XLNC-APEX/WRO_FE_2026_NATIONAL/README.md

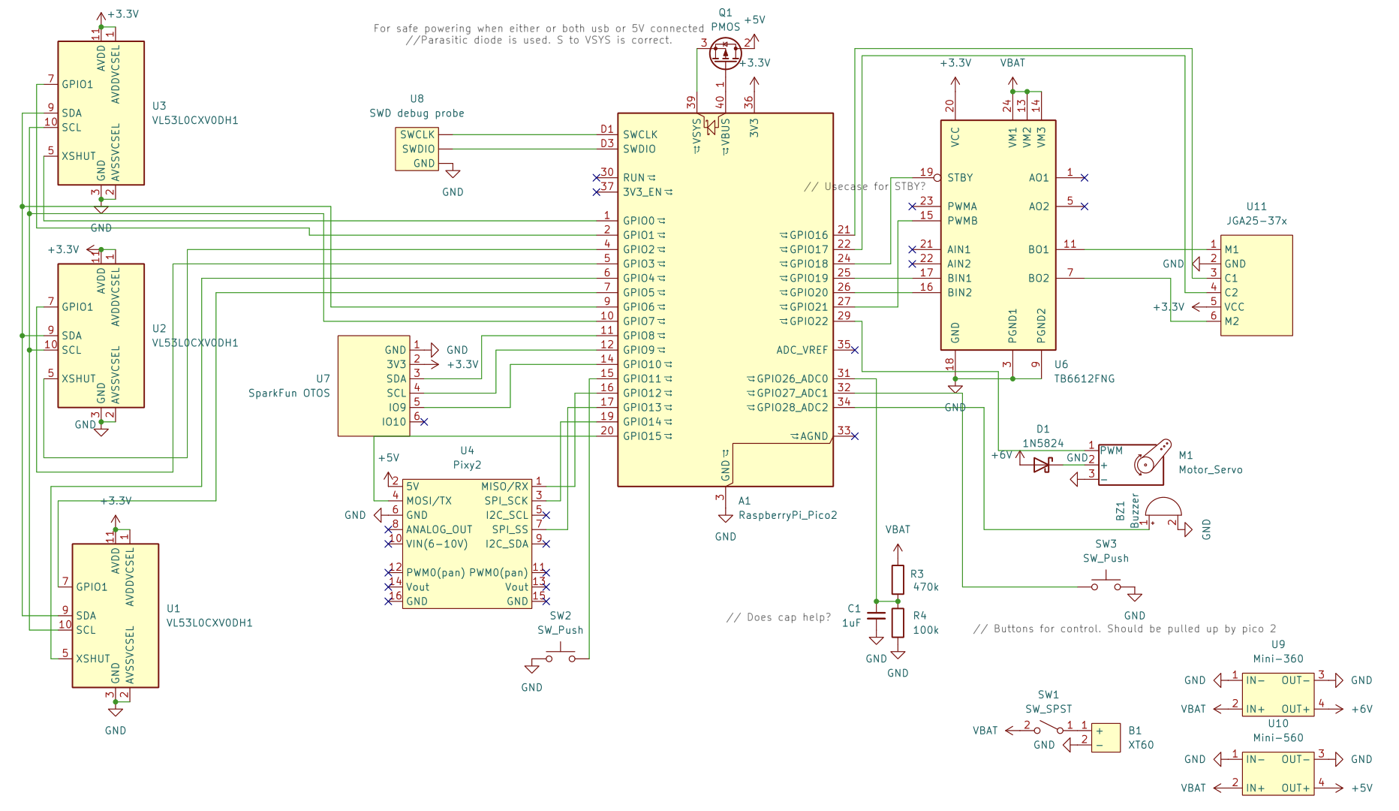
[picture p1: docs/images/schematic.png]
Screenshot of the electronic schematic made in KiCad
