XLNC-APEX/WRO_FE_2026_NATIONAL/hardware/cad/car.png

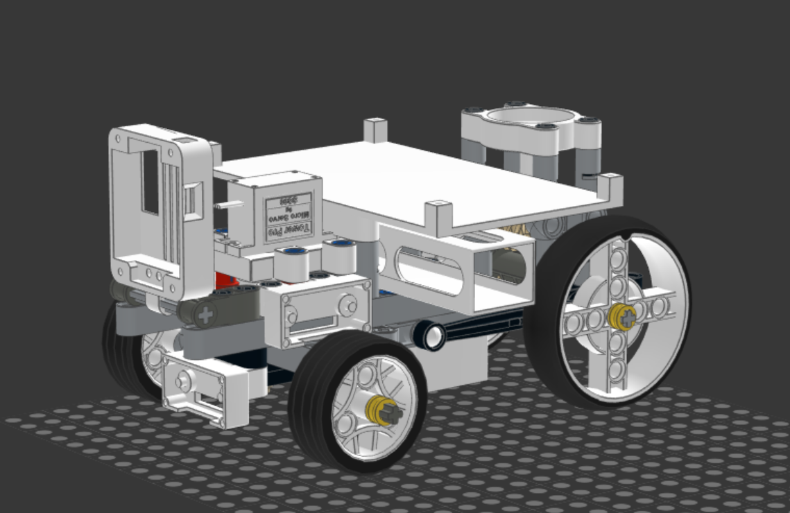
hardware/cad/car.png
