XLNC-APEX/WRO_FE_2026_NATIONAL/hardware/cad/motor.FCStd

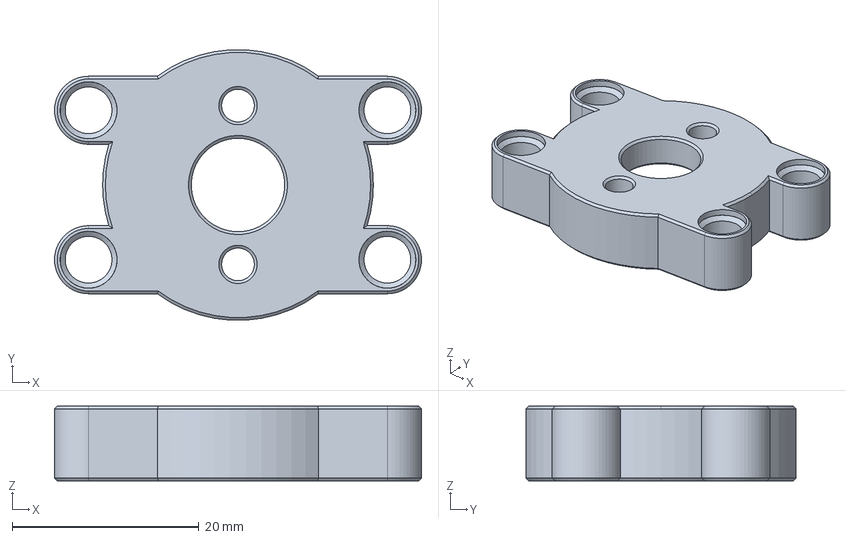
[picture p3: CAD file, 2026-07-25]
hardware/cad/motor.FCStd
39.3 x 29.0 x 8.00 mm
