XLNC-APEX/WRO_FE_2026_NATIONAL/hardware/cad/motor-adapter.FCStd

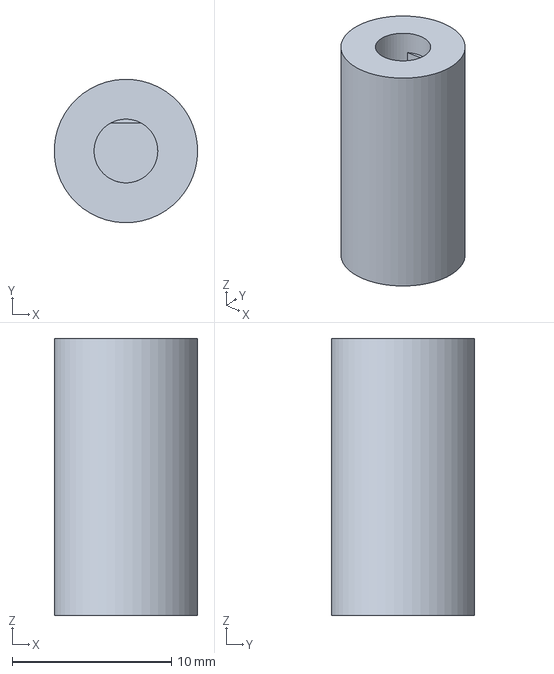
[picture p4: CAD file, 2026-07-25]
hardware/cad/motor-adapter.FCStd
8.99 x 9.00 x 17.4 mm
