XLNC-APEX/WRO_FE_2026_NATIONAL/hardware/cad/perfboard-holder.3mf

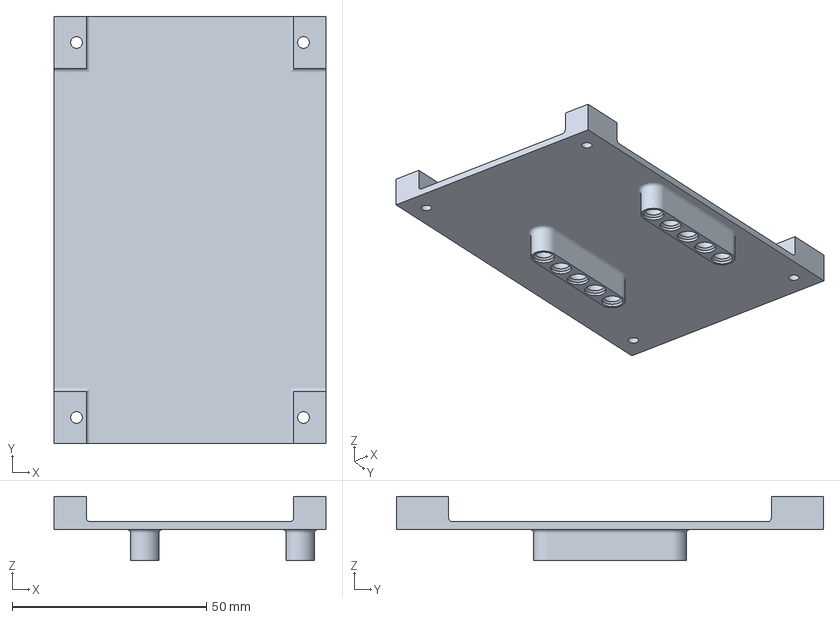
[picture p5: CAD file, 2026-06-13]
hardware/cad/perfboard-holder.3mf
70.0 x 110.0 x 16.5 mm
