XLNC-APEX/WRO_FE_2026_NATIONAL/hardware/cad/tof.FCStd

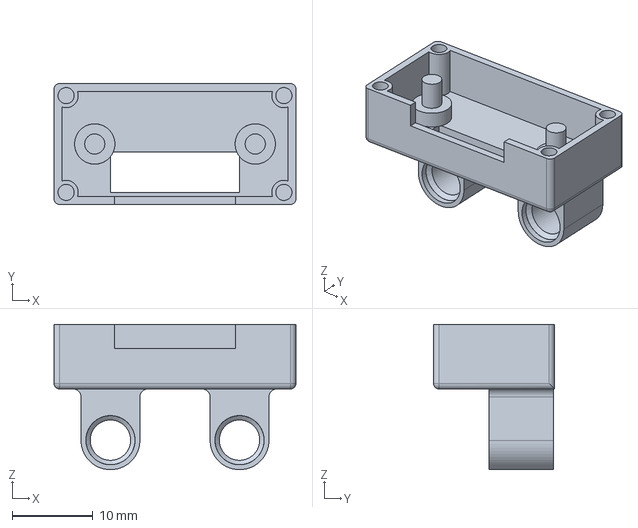
[picture p6: CAD file, 2026-06-13]
hardware/cad/tof.FCStd
30.0 x 15.0 x 18.0 mm
