XLNC-APEX/WRO_FE_2026_NATIONAL/hardware/cad/otos-adapter.3mf

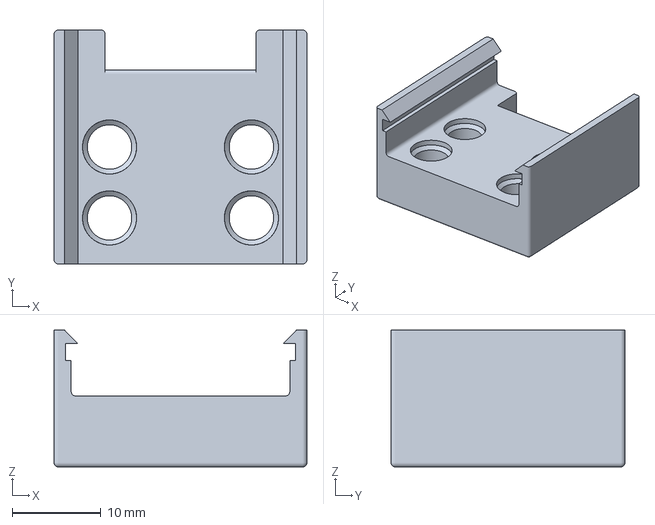
[picture p7: CAD file, 2026-06-13]
hardware/cad/otos-adapter.3mf
28.5 x 26.4 x 15.4 mm
