XLNC-APEX/WRO_FE_2026_NATIONAL/hardware/cad/servo-holder-holder.3mf

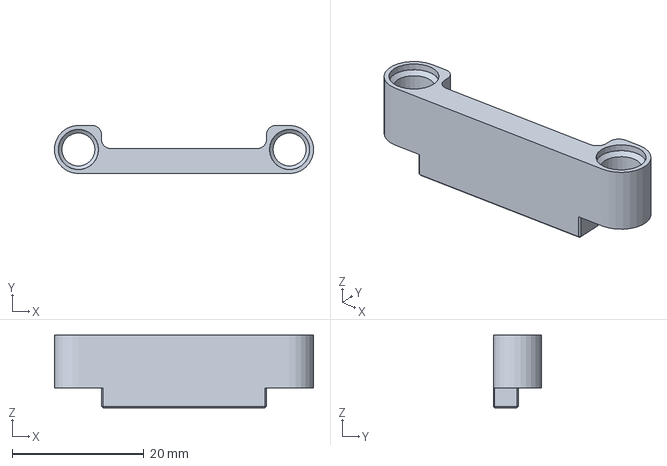
[picture p8: CAD file, 2026-06-13]
hardware/cad/servo-holder-holder.3mf
39.2 x 7.30 x 11.0 mm
