XLNC-APEX/WRO_FE_2026_NATIONAL/hardware/cad/servo-holder.FCStd

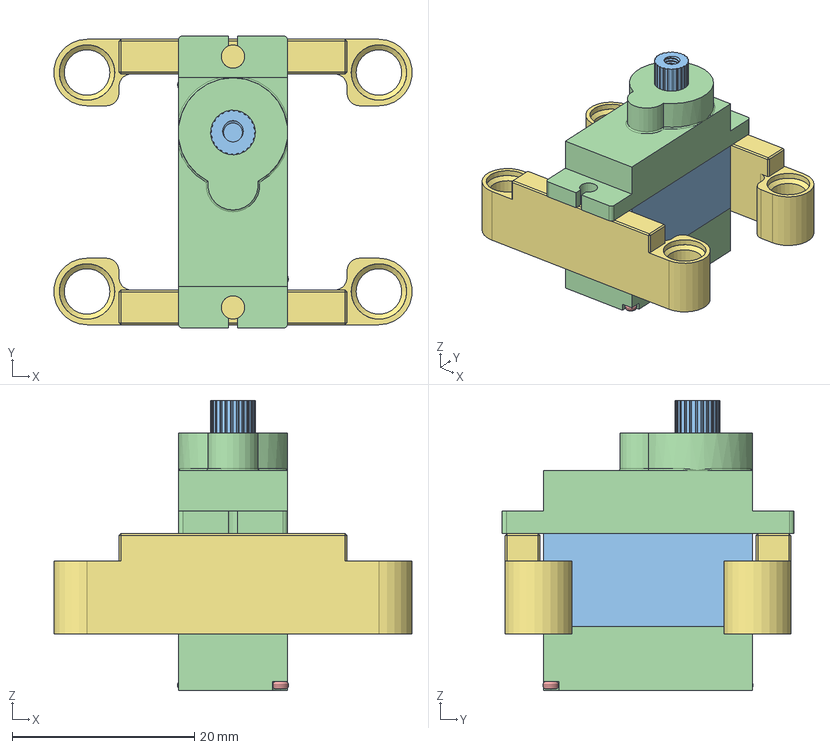
[picture p9: CAD file, 2026-06-13]
hardware/cad/servo-holder.FCStd
39.2 x 32.1 x 31.8 mm
Micro Motor v4
Micro Motor v001
Middel Part v7
Buttom Part v4
Shaft B v4
Gear C v3
Gear C v001
Gear B v1
Gear B v001
Gear A v3
Main Shaft with Gear v3
Upper Part v3
Main Screw v3
Main Screw v001
holder x 2
