XLNC-APEX/WRO_FE_2026_NATIONAL/hardware/cad/servo_adapter.FCStd

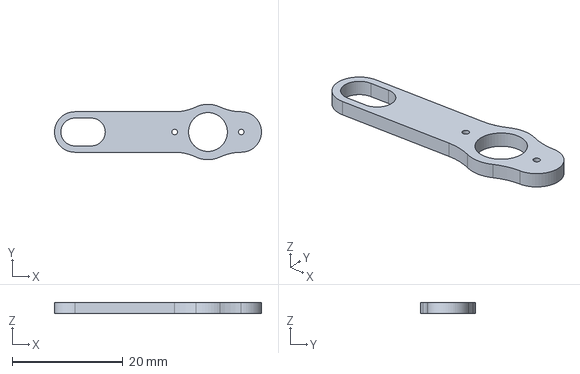
[picture p10: CAD file, 2026-06-13]
hardware/cad/servo_adapter.FCStd
37.3 x 10.00 x 2.05 mm
