XLNC-APEX/WRO_FE_2026_NATIONAL/hardware/cad/battery.FCStd

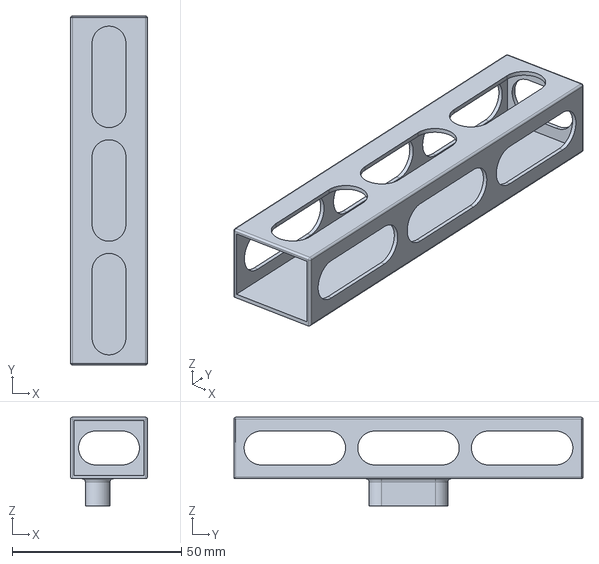
[picture p11: CAD file, 2026-06-08]
hardware/cad/battery.FCStd
22.7 x 103.2 x 26.2 mm
