XLNC-APEX/WRO_FE_2026_NATIONAL/hardware/cad/tof-cover.3mf

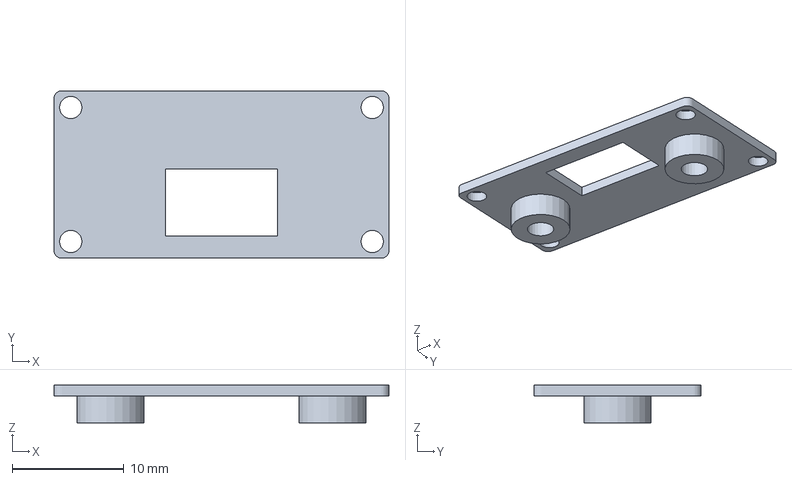
[picture p12: CAD file, 2026-06-06]
hardware/cad/tof-cover.3mf
30.0 x 15.0 x 3.40 mm
