XLNC-APEX/WRO_FE_2026_NATIONAL/hardware/cad/pixy_2_case.3mf

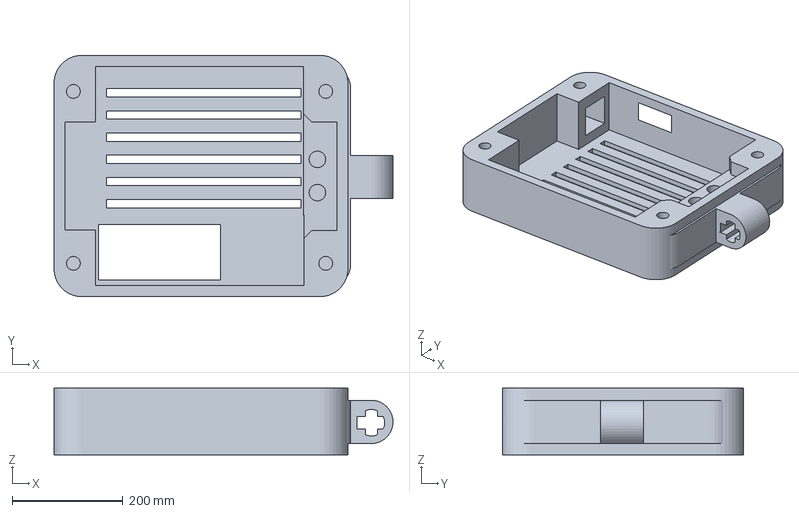
[picture p13: CAD file, 2026-06-06]
hardware/cad/pixy_2_case.3mf
611.2 x 435.0 x 120.0 mm
