XLNC-APEX/WRO_FE_2026_NATIONAL/hardware/cad/servo.FCStd

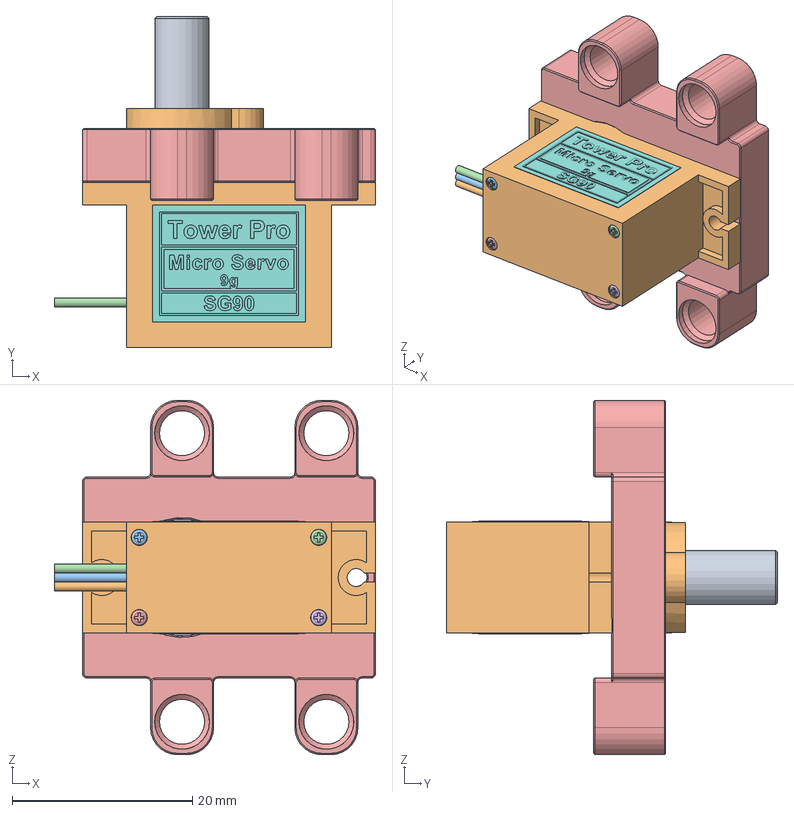
[picture p14: CAD file, 2026-06-03]
hardware/cad/servo.FCStd
35.6 x 36.7 x 39.3 mm
adapter
SG90 v1
SG90 v001
SG90 v002
SG90 v003
SG90 v004
SG90 v005
SG90 v006
SG90 v007
SG90 v008
SG90 v009
SG90 v010
holder
