XLNC-APEX/WRO_FE_2026_NATIONAL/(list of files, cad)

Other CAD files:
hardware/cad/perfboard.FCStd
hardware/cad/tof-case.3mf
hardware/cad/otos.FCStd
hardware/cad/battery-holder.3mf
hardware/cad/motor-holder.3mf
hardware/cad/motor-adapter.3mf
hardware/cad/servo-adapter.3mf
hardware/cad/servo-holder.3mf
