XLNC-APEX/WRO_FE_2026_NATIONAL/hardware/schematics/car/car.kicad_pcb

## KiCad design hardware/schematics/car/car.kicad_pcb (2026-06-13)

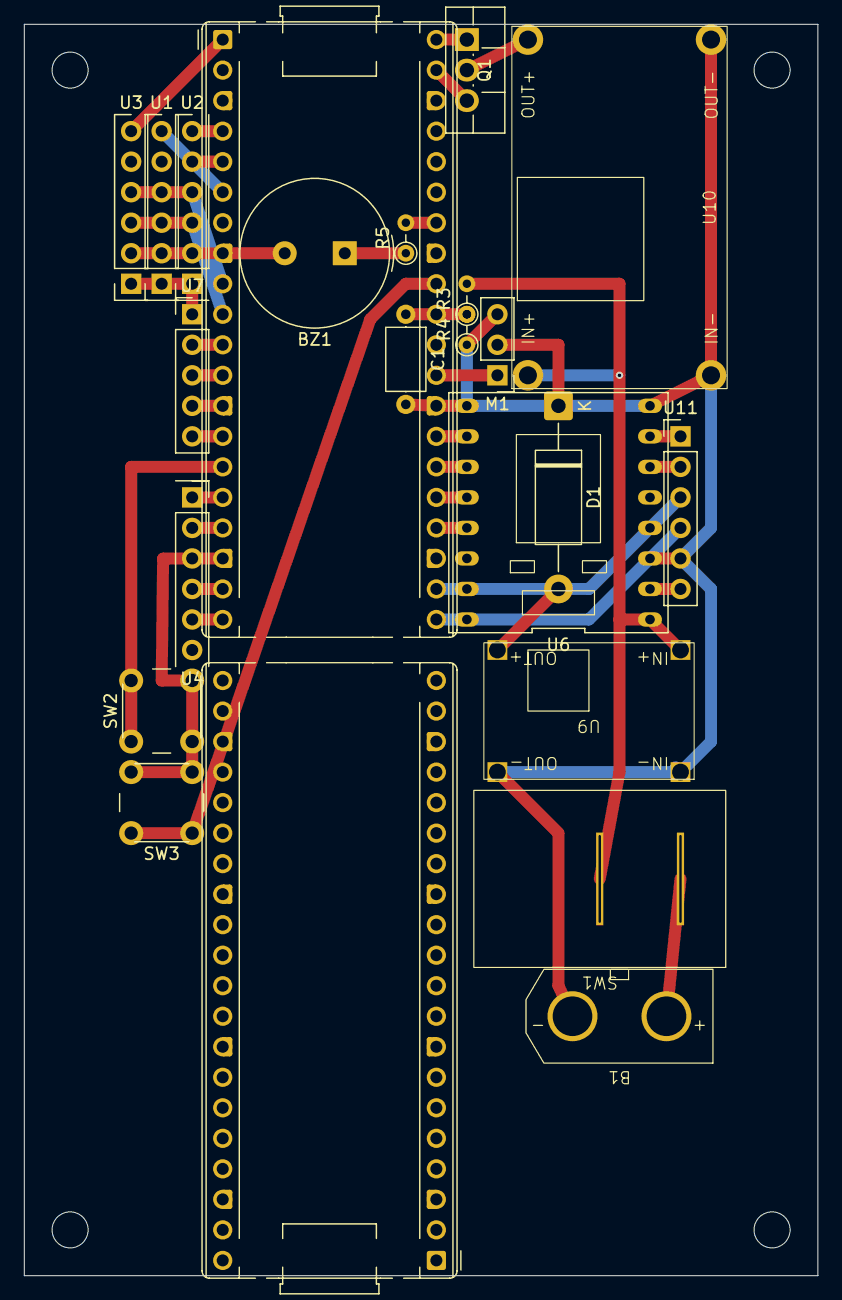
[picture p15: board car.kicad_pcb from above]

Board: 12 copper layers, 66.0 x 104.1 mm, 23 parts (0 on the bottom side), 38 nets.

Parts:
A1, A1#2: RaspberryPi_Pico2; RaspberryPi_Pico_Common_THT
B1: XT60
BZ1: Buzzer; Buzzer_TDK_PS1240P02BT_D12.2mm_H6.5mm
C1: 1uF; C_Axial_L5.1mm_D3.1mm_P7.50mm_Horizontal
D1: 1N5824; D_DO-15_P15.24mm_Horizontal
M1: Motor_Servo; PinHeader_1x03_P2.54mm_Vertical
Q1: PMOS; TO-220F-3_Vertical
R3: 470k; R_Axial_DIN0204_L3.6mm_D1.6mm_P2.54mm_Vertical
R4: 100k; R_Axial_DIN0204_L3.6mm_D1.6mm_P2.54mm_Vertical
R5: 200; R_Axial_DIN0204_L3.6mm_D1.6mm_P2.54mm_Vertical
SW1: SW_SPST; SW_SPST_20.96mmx14.74mm
SW2, SW3: SW_Push; SW_PUSH_6mm_5.08mm
U1, U2, U3: VL53L0CXV0DH1; VL53L0_1XV2_PinHeader_1x06_P2.54mm_Vertical
U4: Pixy2; Pixy2_PinHeader_1x06_P2.54mm_Vertical
U6: TB6612FNG; TB6612FNG_Breakout_Sparkfun
U7: SparkFun OTOS; Sparkfun_OTOS_PinHeader_1x05_P2.54mm_Vertical
U9: Mini-360; Buck_Mini-360_2.54mm
U10: Mini-560; Buck_Mini-560_2.54mm
U11: JGA25-37x; JGA25-37x_PinHeader_1x06_P2.54mm_Vertical

Connections:
+3.3V: A1.36 (3V3), A1#2.36 (3V3), U1.11 (AVDD), U2.11 (AVDD), U3.11 (AVDD), U6.20 (VCC), U7.2 (3V3), U11.5 (VCC)
+5V: Q1.2 (D), U4.2 (5V), U10.4 (OUT+)
+6V: D1.2 (A), U9.4 (OUT+)
GND: A1.3 (GND), A1.8 (GND), A1.13 (GND), A1.18 (GND), A1.23 (GND), A1.28 (GND), A1.38 (GND), A1#2.3 (GND), A1#2.8 (GND), A1#2.13 (GND), A1#2.18 (GND), A1#2.23 (GND), A1#2.28 (GND), A1#2.38 (GND), B1.2 (-), BZ1.2 (-), C1.2, M1.3 (-), R4.1, SW2.2, SW3.2, U1.3 (GND), U2.3 (GND), U3.3 (GND), U4.6 (GND), U6.18 (GND), U7.1 (GND), U9.1 (IN-), U9.3 (OUT-), U10.1 (IN-), U10.3 (OUT-), U11.2 (GND)
unnamed: A1.1 (GPIO0), A1#2.1 (GPIO0), U3.5 (XSHUT)
unnamed: A1.2 (GPIO1), A1#2.2 (GPIO1), U3.7 (GPIO1)
unnamed: A1.4 (GPIO2), A1#2.4 (GPIO2), U2.5 (XSHUT)
unnamed: A1.5 (GPIO3), A1#2.5 (GPIO3), U2.7 (GPIO1)
unnamed: A1.6 (GPIO4), A1#2.6 (GPIO4), U1.5 (XSHUT)
unnamed: A1.7 (GPIO5), A1#2.7 (GPIO5), U1.7 (GPIO1)
unnamed: A1.9 (GPIO6), A1#2.9 (GPIO6), U1.9 (SDA), U2.9 (SDA), U3.9 (SDA)
unnamed: A1.10 (GPIO7), A1#2.10 (GPIO7), U1.10 (SCL), U2.10 (SCL), U3.10 (SCL)
unnamed: A1.11 (GPIO8), A1#2.11 (GPIO8), U7.3 (SDA)
unnamed: A1.12 (GPIO9), A1#2.12 (GPIO9), U7.4 (SCL)
unnamed: A1.14 (GPIO10), A1#2.14 (GPIO10), U7.5 (IO9)
unnamed: A1.15 (GPIO11), A1#2.15 (GPIO11), SW2.1
unnamed: A1.16 (GPIO12), A1#2.16 (GPIO12), U4.1 (MISO/RX)
unnamed: A1.17 (GPIO13), A1#2.17 (GPIO13), U4.7 (SPI_SS)
unnamed: A1.19 (GPIO14), A1#2.19 (GPIO14), U4.3 (SPI_SCK)
unnamed: A1.20 (GPIO15), A1#2.20 (GPIO15), U4.4 (MOSI/TX)
unnamed: A1.21 (GPIO16), A1#2.21 (GPIO16), U11.3 (C1)
unnamed: A1.22 (GPIO17), A1#2.22 (GPIO17), U11.4 (C2)
unnamed: A1.24 (GPIO18), A1#2.24 (GPIO18), U6.19 (STBY)
unnamed: A1.25 (GPIO19), A1#2.25 (GPIO19), U6.17 (BIN1)
unnamed: A1.26 (GPIO20), A1#2.26 (GPIO20), U6.16 (BIN2)
unnamed: A1.27 (GPIO21), A1#2.27 (GPIO21), U6.15 (PWMB)
unnamed: A1.29 (GPIO22), A1#2.29 (GPIO22), M1.1 (PWM)
unnamed: A1.31 (GPIO26_ADC0), A1#2.31 (GPIO26_ADC0), C1.1, R3.1, R4.2
unnamed: A1.32 (GPIO27_ADC1), A1#2.32 (GPIO27_ADC1), SW3.1
unnamed: A1.34 (GPIO28_ADC2), A1#2.34 (GPIO28_ADC2), R5.2
unnamed: A1.40 (VBUS), A1#2.40 (VBUS), Q1.1 (G)
unnamed: A1.39 (VSYS), A1#2.39 (VSYS), Q1.3 (S)
unnamed: B1.1 (+), SW1.1 (A)
unnamed: BZ1.1 (+), R5.1
unnamed: D1.1 (K), M1.2 (+)
unnamed: U6.11 (BO1), U11.1 (M1)
unnamed: U6.7 (BO2), U11.6 (M2)
VBAT: R3.2, SW1.2 (B), U6.24 (VM1), U9.2 (IN+), U10.2 (IN+)
