XLNC-APEX/WRO_FE_2026_NATIONAL/firmware/xlnc_apex_robot/src/main.rs

#![no_std]
#![no_main]

extern crate embassy_rp as hal;
use core::f32::consts::FRAC_PI_6;

use defmt::info;
use embassy_executor::Spawner;
use embassy_time::Timer;
use hal::block::ImageDef;
use nalgebra::Point2;
use xlnc_apex_robot::{
    path::LinesPath,
    target::{ApexCar, PurePursuit, PurePursuitConfig, beeper_task, btn_reset, init, pure_pursuit},
};

//Panic Handler
use panic_probe as _;
// Defmt Logging
use defmt_rtt as _;

/// Tell the Boot ROM about our application
#[unsafe(link_section = ".start_block")]
#[used]
pub static IMAGE_DEF: ImageDef = hal::block::ImageDef::secure_exe();

#[embassy_executor::main]
async fn main(spawner: Spawner) {
    let p = hal::init(Default::default());
    let mut devices = init(p).await;
    info!("{}", devices.voltage.get().await.unwrap());
    info!("Intialized! Press btn2 to start. Then btn1 to reset.");
    devices.btn2.wait_for_low().await;
    spawner.spawn(beeper_task(devices.buzzer).unwrap()); // beep();
    spawner.spawn(btn_reset(devices.btn1, devices.watchdog).unwrap());

    devices.otos.reset_tracking().await.unwrap();
    devices.otos.calibrate_imu(255).await.unwrap();
    let ppconf = PurePursuitConfig {
        kl: 1.0,
        min_l: 0.1,
        max_l: 0.5,
        l_drv: 0.096,
        max_steer: FRAC_PI_6,
    };
    let car = ApexCar::new(devices.servo, devices.otos);
    let path_points = [
        Point2::new(0.0, 0.0),
        Point2::new(1.5, 0.0),
        Point2::new(1.5, 1.5),
        Point2::new(0.0, 1.5),
        Point2::new(0.0, 0.0),
        Point2::new(1.5, 0.0),
        Point2::new(1.5, 1.5),
        Point2::new(0.0, 1.5),
        Point2::new(0.0, 0.0),
        Point2::new(1.5, 0.0),
        Point2::new(1.5, 1.5),
        Point2::new(0.0, 1.5),
        Point2::new(0.0, 0.0),
        Point2::new(1.5, 0.0),
        Point2::new(1.5, 1.5),
        Point2::new(0.0, 1.5),
        Point2::new(0.0, 0.0),
        Point2::new(1.5, 0.0),
        Point2::new(1.5, 1.5),
        Point2::new(0.0, 1.5),
        Point2::new(0.0, 0.0),
    ];
    let path = LinesPath::new(path_points);
    let pp = PurePursuit::new(car, path, ppconf);
    spawner.spawn(pure_pursuit(pp, devices.motor, devices.tof_right).unwrap());

    loop {
        Timer::after_millis(100).await;
    }
}

// Program metadata for `picotool info`.
// This isn't needed, but it's recommended to have these minimal entries.
#[unsafe(link_section = ".bi_entries")]
#[used]
pub static PICOTOOL_ENTRIES: [embassy_rp::binary_info::EntryAddr; 4] = [
    embassy_rp::binary_info::rp_program_name!(c"xlnc_apex_robot"),
    embassy_rp::binary_info::rp_program_description!(c"your program description"),
    embassy_rp::binary_info::rp_cargo_version!(),
    embassy_rp::binary_info::rp_program_build_attribute!(),
];

// End of file
