XLNC-APEX/WRO_FE_2026_NATIONAL/(commit log)

2026-05-09 Initial, almost empty. Put placeholder files to add folder to git. Just started CAD
    [car.FCStd]
2026-05-09 CAD: add steering master sketch(depends on horizontal master). Create body(pad) of side steering plank.
    [car.FCStd]
2026-05-11 Change directory structure. Start KiCad schematic.
    [car.FCStd, car.kicad_sch]
2026-05-29 [Schematic] Major work. Add: TOFs, Motor, servo, buzzer, ADC(WIP), level shifter. WIP
    [car.kicad_sch]
2026-05-29 [Schematic] Minor: Change datasheet and name to pico 2
    [car.kicad_sch]
2026-05-29 [Schematic] Servo: add schottky diode on power 1N5824
    [car.kicad_sch]
2026-05-30 [Schematic] Create Pixy2, OTOS, debug probe symbols. Add *.bak to .gitignore
2026-05-30 Use default background for symbols. Import our library into schematic project
2026-05-30 [Schematic] Add OTOS, Pixy, Debug probe, 2 buttons, fix voltage divider
    [car.kicad_sch]
2026-05-31 [Schematic] Create buck converters: mini 360, 560 symbols, footprints
2026-05-31 [Schematic] Add buck converters, put resitances on ADC.
    [car.kicad_sch]
2026-05-31 [Schematic] Major work: add many perfboard footprints, fix spi wrong
    [car.kicad_pcb, car.kicad_sch]
2026-06-02 [Schematic] mosfet fix. Use parasitic diode in our advantage
    [car.kicad_sch]
2026-06-02 [Schematic] add JGA25-37x symbol
2026-06-02 [Schematic] fix wrong footprint for JGA25-37x symbol
2026-06-02 [Schematic] use jga motor connector instead
    [car.kicad_sch]
2026-06-02 [Schematic] TB6612FNG breakout footprint
2026-06-02 [Schematic] schematic: use TB6612FNG breakout footprint
    [car.kicad_sch]
2026-06-02 [Schematic] create 4ch level shifter bss138 symbol and footprint
2026-06-02 [Schematic] Use simpler, smaller level shifter
    [car.kicad_sch]
2026-06-02 [Schematic] Fix super suboptimal connection for level shifter(was like cross thing)
    [car.kicad_sch]
2026-06-02 [Schematic] update pcb components
    [car.kicad_pcb]
2026-06-02 [Schematic] Some pcb movings
    [car.kicad_pcb]
2026-06-03 [Schematic] Remove level shifter. The pixy2 seems to have 3.3v outputs, maybe 3.3v tolerable input? Need testing.
    [car.kicad_sch]
2026-06-03 add servo adapter and holder cad
    [servo-adapter.3mf, servo-holder.3mf, servo.FCStd]
2026-06-03 Add xt60 symbol and footprint
2026-06-03 [Schematic] fix mosfet, add xt60
    [car.kicad_sch]
2026-06-03 [Schematic] Change button footprint. PCB: move around, connect easy things.
    [car.kicad_pcb, car.kicad_sch]
2026-06-03 [Schematic] Fix mini560 footprint. PCB: some moving.
    [car.kicad_pcb]
2026-06-03 [Schematic] Add battery switch.
    [car.kicad_sch]
2026-06-03 [Schematic] Add battery switch to pcb.
    [car.kicad_pcb]
2026-06-04 add motor adapter
    [motor-adapter.3mf, motor-holder.3mf, motor.FCStd]
2026-06-04 [Schematic] Fix footprints.
    [car.kicad_sch]
2026-06-04 [Schematic] Major work: rewire schematic, route all perfboard, many fixes, additions.
    [car.kicad_pcb, car.kicad_sch]
2026-06-05 [Schematic] Add 200ohm R in series with buzzer to limit current.
    [car.kicad_pcb, car.kicad_sch]
2026-06-05 [CAD] Add otos adapter cad
    [otos-adapter.3mf, otos.FCStd]
2026-06-05 [Schematic] Add pcb viweing presets for reference when soldering.
2026-06-05 [Schematic] Fix TB6612FNG by one wider fotoprint.
2026-06-05 [Schematic] reroute the fixed footprint.
    [car.kicad_pcb]
2026-06-05 [Schematic] Move left by one motor connector.
    [car.kicad_pcb]
2026-06-06 [Schematic] Minor change: add leyer for preset viewing in pcb.
2026-06-06 [CAD] add tof sensor and pixy2 adapter
    [pixy_2_case.3mf, tof-case.3mf, tof-cover.3mf, tof.FCStd]
2026-06-08 [CAD] add perfboard and battery holder
    [battery-holder.3mf, battery.FCStd, car.FCStd, perfboard-holder.3mf, perfboard.FCStd]
2026-06-08 [Schematic] moved mini-360 to replace it and not clean the through holes.
    [car.kicad_pcb]
2026-06-10 Add init almost all components code(forgot buttons). Does not crash)))
    [lib.rs, main.rs]
2026-06-10 Fix motor: prevent stby pin var dropping. Add 2 buttons, Add example embassy task
    [lib.rs, main.rs]
2026-06-11 Add potential holes in perfboard
    [car.kicad_pcb]
2026-06-13 [CAD] Add new servo adapter
    [servo-adapter.3mf, servo_adapter.FCStd]
2026-06-13 [CAD] Update servo adapter 3mf file
    [servo-adapter.3mf]
2026-06-13 [CAD] add servo-holder
    [otos.FCStd, servo-holder-holder.3mf, servo-holder.FCStd, tof-case.3mf]
2026-06-13 [CAD] Revert to older otos holder version
    [otos.FCStd]
2026-06-13 [CAD] Otos, make space for it and pin headers to fit
    [otos-adapter.3mf, otos.FCStd]
2026-06-13 [CAD] Improve perfboard holder. Changes in motor, otos adapter(printed), tof
    [motor-adapter.3mf, motor.FCStd, otos-adapter.3mf, perfboard-holder.3mf, perfboard.FCStd, tof-case.3mf, tof.FCStd]
2026-06-13 [Schematic] PCB: Change holes and boundary to real. Add second pico(just visual)
    [car.kicad_pcb]
2026-06-14 [Code] Added watchdog, buzzer song player to devices. Updated deps(fixes pixy init)
    [lib.rs, main.rs]
2026-06-14 [CAD] Update the working motor adapter
    [motor-adapter.3mf, motor.FCStd]
2026-06-14 [Code] fix servo wrong angle dir. Make motor_servo_play try go lateral
    [lib.rs]
2026-06-15 [Code] fixed tof error
    [lib.rs, main.rs]
2026-06-15 [Code] rename tof sensors
2026-06-18 Add schematic image/screenshot.
2026-06-18 Place schematic image into README.md
2026-06-21 [Code] Reset in btn press task
    [lib.rs, main.rs]
2026-07-21 [Code] Update deps, fix rename in SparkFunOTOS
    [lib.rs]
2026-07-25 [Code] Set correct OTOS offset, update deps
    [lib.rs]
2026-07-25 [CAD] New correct length, stronger (hopefully) motor adapter in new CAD. Remove old motor adapter.
    [motor-adapter.3mf, motor-adapter.FCStd, motor.FCStd]
2026-07-28 [Code] Simpler Host/target separation using cfg(target_os = "none"). Fixes rust-analyzer, no `-F target` needed, tests can be lauched from vscode.
    [lib.rs]
2026-08-12 SQUASH THIS [Code] PurePursuit: possibly correct predict_pos(). Tested at (30, 25)deg => (2.3, 5)% error. Need low angle testing.
    [follower.rs]
2026-08-12 [Code] PurePursuit: use new path. Broken: steer at least is wrong.
    [follower.rs, lib.rs, main.rs]
2026-08-12 [Code] PurePursuit: corrected obvious wrongs, still BROKEN. Steering is unstable and random.
    [follower.rs]
